opcow/ender_3_fanbox/fan_housing_v4.png

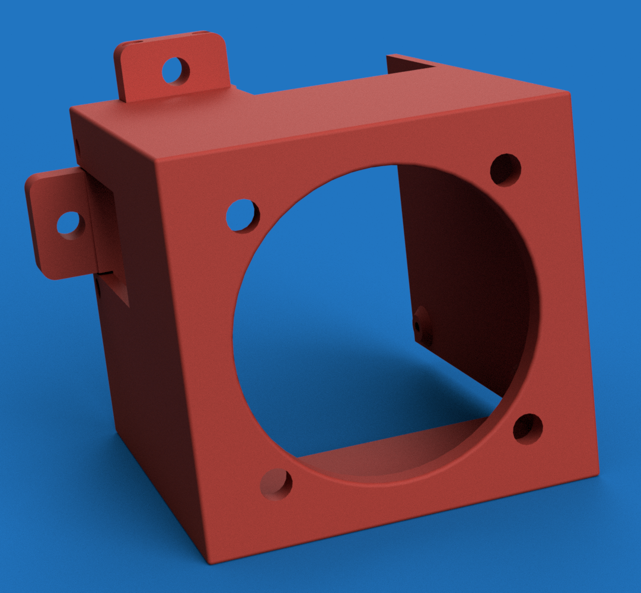
fan_housing_v4.png
