opcow/ender_3_fanbox/Bracket Top.stl

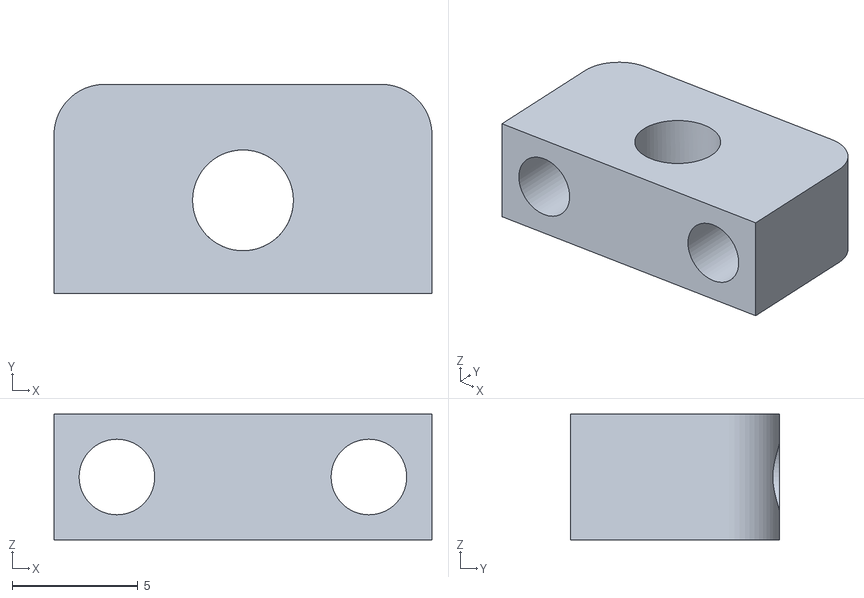
[picture p2: CAD file, 2019-01-08]
Bracket Top.stl
15.0 x 8.30 x 5.00
