opcow/ender_3_fanbox/Bracket Left.stl

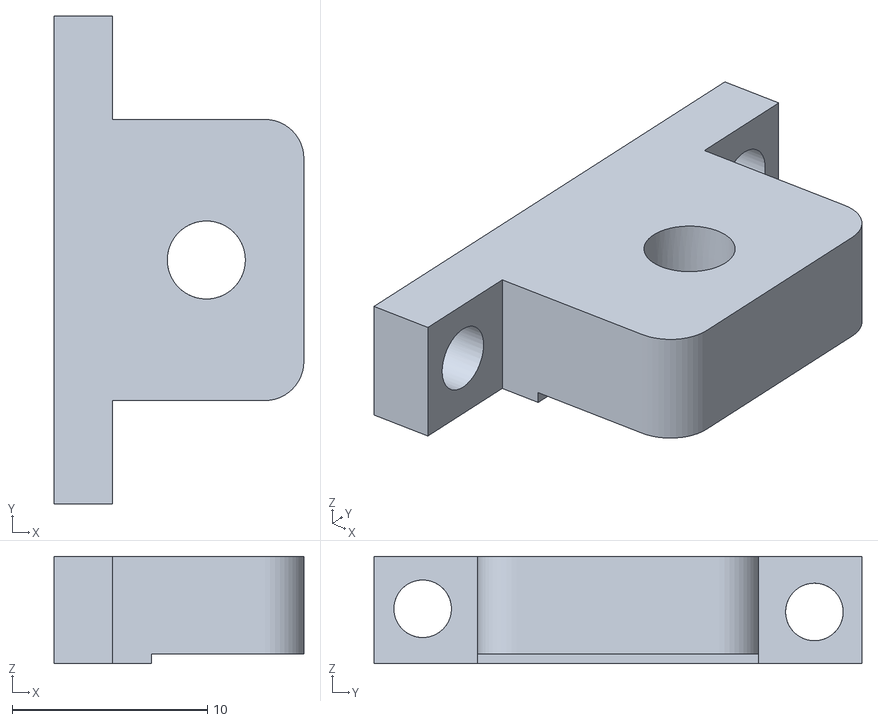
[picture p3: CAD file, 2019-01-08]
Bracket Left.stl
12.8 x 25.0 x 5.50
