opcow/ender_3_fanbox/Housing.stl

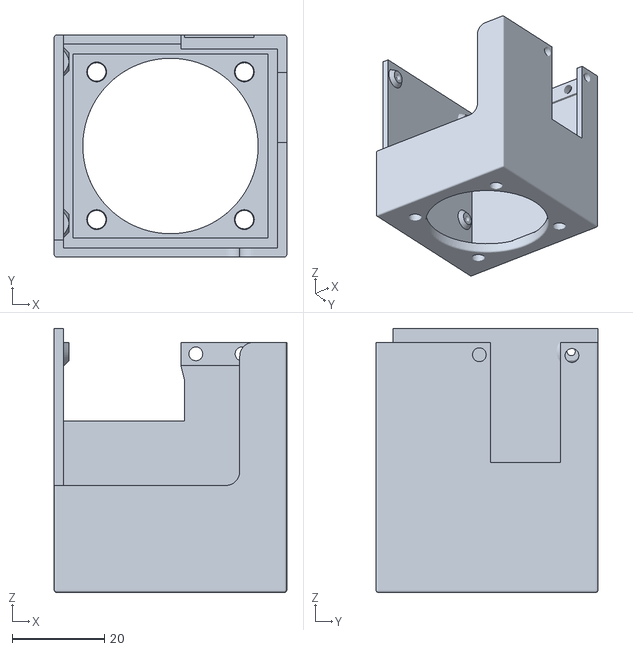
[picture p4: CAD file, 2019-01-08]
Housing.stl
50.4 x 48.1 x 57.2
